BastaMasta/LumioV2/Hardware/LumioV2.pdf

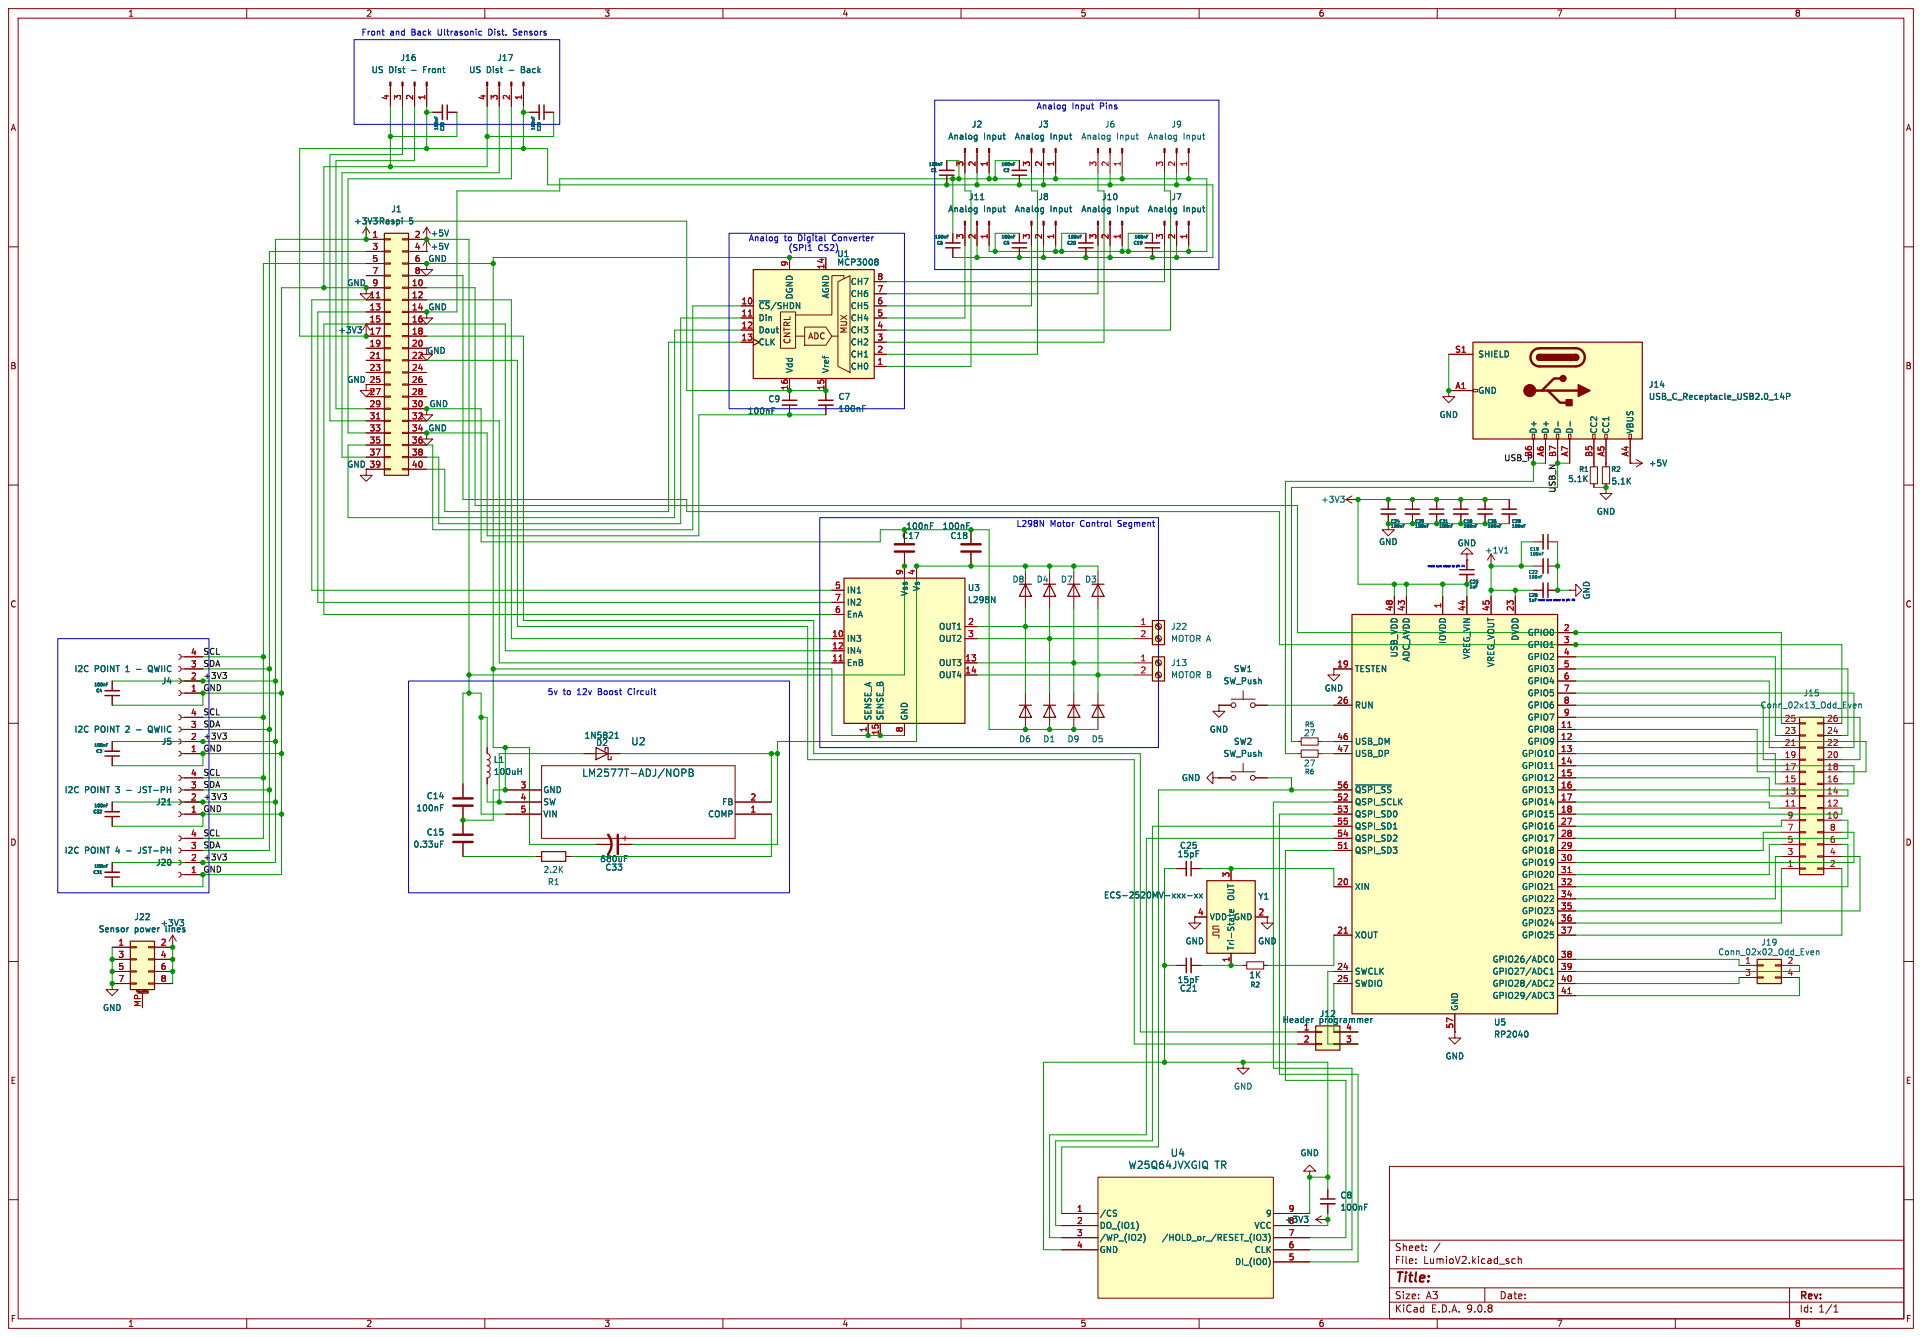
[picture p1: page 1]

1 GND 57 VREG_VIN 44 VREG_VOUT 45 DVDD 23 GPIO0 2 GPIO1 3 GPIO2 4 GPIO3 5 GPIO4 6 GPIO5 7 GPIO6 8 GPIO7 9 GPIO8 11 GPIO9 12 GPIO10 13 GPIO11 14 GPIO12 15 GPIO13 16 GPIO14 17 GPIO15 18 GPIO16 27 GPIO17 28 GPIO18 29 GPIO19 30 GPIO20 31 GPIO21 32 GPIO22 34 GPIO23 35 GPIO24 36 GPIO25 37 GPIO26/ADC0 38 GPIO27/ADC1 39 GPIO28/ADC2 40 GPIO29/ADC3 41 U5 RP2040 GND Tri-State
J12 Header programmer R6 27

3 ECS-2520MV-xxx-xx Y1 GND
