BastaMasta/LumioV2/(list of files, drawings)

Other design files:
Hardware/freerouting.dsn
Hardware/temp-freerouting.dsn
