BastaMasta/LumioV2/Hardware/LumioV2.kicad_pcb

## KiCad design Hardware/LumioV2.kicad_pcb (2026-04-07)

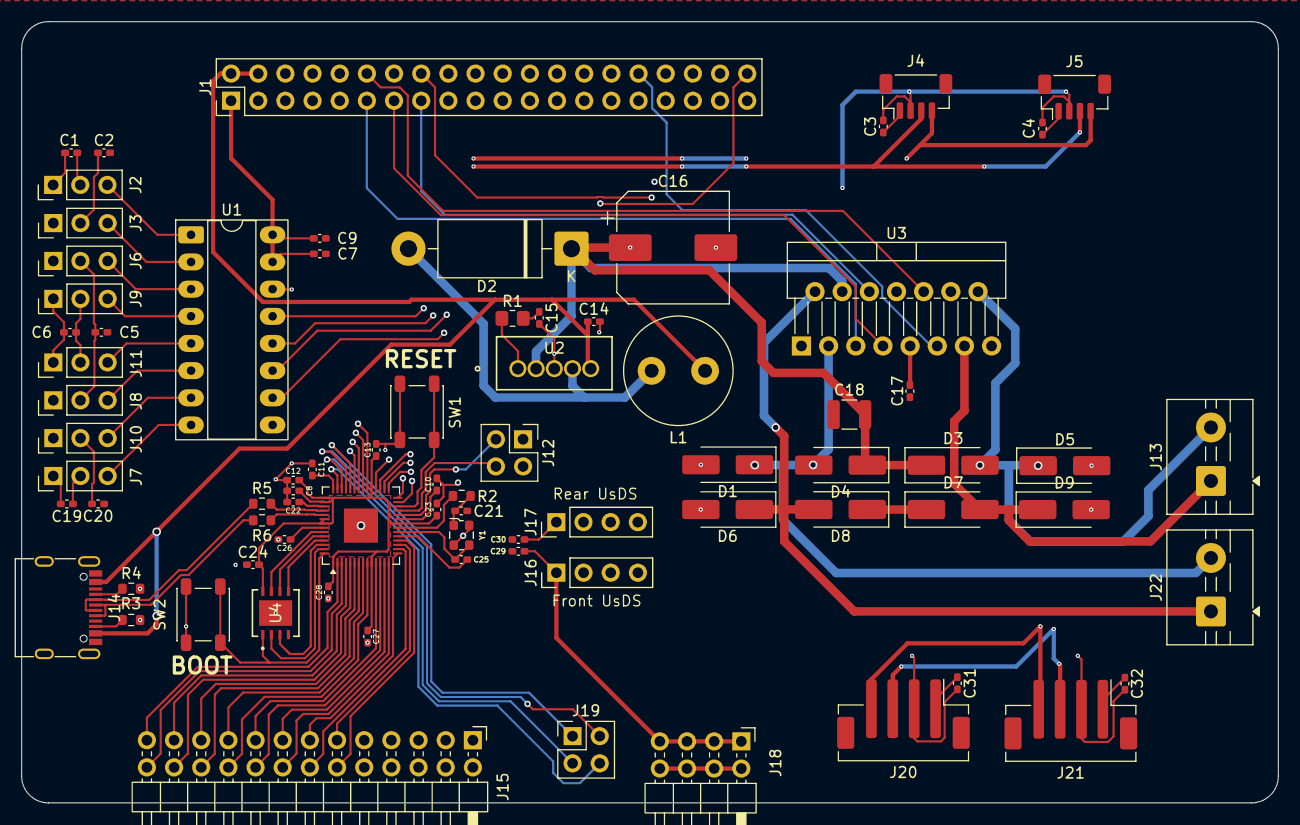
[picture p2: board LumioV2.kicad_pcb from above]

Board: 4 copper layers, 117.5 x 73.0 mm, 79 parts (1 on the bottom side), 86 nets.

Parts:
C1, C2, C3, C4, C5, C6, C7, C8, C9, C11, C12, C14, C17, C19, C20, C24, C28, C29, C30, C31, C32: 100nF; C_0402_1005Metric_Pad0.74x0.62mm_HandSolder
C10, C13, C22, C23, C26, C27: 1uF; C_0402_1005Metric_Pad0.74x0.62mm_HandSolder
C15: 0.33uF; C_0402_1005Metric_Pad0.74x0.62mm_HandSolder
C16, C33: 680uF; CP_Elec_10x10
C18: 100nF; C_1210_3225Metric
C21, C25: 15pF; C_0402_1005Metric_Pad0.74x0.62mm_HandSolder
D1, D3, D4, D5, D6, D7, D8, D9: SS34B; D_SMA_Handsoldering
D2: 1N5821; D_DO-201AD_P15.24mm_Horizontal
J1: Raspi 5; PinHeader_2x20_P2.54mm_Vertical
J2, J3, J6, J7, J8, J9, J10, J11: Analog Input; PinHeader_1x03_P2.54mm_Vertical
J4: I2C POINT 1 - QWIIC; JST_SH_BM04B-SRSS-TB_1x04-1MP_P1.00mm_Vertical
J5: I2C POINT 2 - QWIIC; JST_SH_BM04B-SRSS-TB_1x04-1MP_P1.00mm_Vertical
J12: Header programmer; PinHeader_2x02_P2.54mm_Vertical
J13: MOTOR B; TerminalBlock_MaiXu_MX126-5.0-02P_1x02_P5.00mm
J14: USB_C_Receptacle_USB2.0_14P; USB_C_Receptacle_G-Switch_GT-USB-7010ASV
J15: Conn_02x13_Odd_Even; PinHeader_2x13_P2.54mm_Horizontal
J16: US Dist - Front; PinHeader_1x04_P2.54mm_Vertical
J17: US Dist - Back; PinHeader_1x04_P2.54mm_Vertical
J18: Sensor power lines; PinHeader_2x04_P2.54mm_Horizontal
J19: Conn_02x02_Odd_Even; PinHeader_2x02_P2.54mm_Vertical
J20: I2C POINT 4 - JST-PH; JST_PH_B4B-PH-SM4-TB_1x04-1MP_P2.00mm_Vertical
J21: I2C POINT 3 - JST-PH; JST_PH_B4B-PH-SM4-TB_1x04-1MP_P2.00mm_Vertical
J22: MOTOR A; TerminalBlock_MaiXu_MX126-5.0-02P_1x02_P5.00mm
L1: 100uH; L_Radial_D10.0mm_P5.00mm_Fastron_07M
R1: 2.2K; R_0805_2012Metric_Pad1.20x1.40mm_HandSolder
R2: 1K; R_0603_1608Metric
R3, R4: 5.1K; R_0603_1608Metric
R5, R6: 27; R_0603_1608Metric
SW1, SW2: SW_Push; SW_SPST_PTS647_Sx50
U1: MCP3008; DIP-16_W7.62mm_Socket_LongPads
U2: LM2577T-ADJ/NOPB; T05A_TEX
U3: L298N; TO-220-15_P2.54x5.08mm_StaggerOdd_Lead4.58mm_Vertical
U4: DFN_XGIQ_TR_WIN; DFN_XGIQ TR_WIN-M
U5: RP2040; QFN-56-1EP_7x7mm_P0.4mm_EP3.2x3.2mm
Y1: ECS-2520MV-xxx-xx; Oscillator_SMD_ECS_2520MV-xxx-xx-4Pin_2.5x2.0mm

Connections:
+1V1: C10.2, C22.2, C26.2, U5.23 (DVDD), U5.45 (VREG_VOUT), U5.50 (DVDD)
+3V3: C1.1, C2.1, C3.2, C4.2, C5.1, C6.1, C7.1, C8.2, C9.1, C11.2, C12.2, C13.2, C19.1, C20.1, C23.2, C24.2, C27.2, C28.2, C29.2, C30.2, C31.2, C32.2, J1.1, J1.17 (3V3), J2.2, J3.2, J4.2, J5.2, J6.2, J7.2, J8.2, J9.2, J10.2, J11.2, J16.1, J17.1, J18.1, J18.3, J18.5, J18.7, J20.2, J21.2, U1.15 (Vref), U1.16 (Vdd), U4.8, U5.1 (IOVDD), U5.10 (IOVDD), U5.22 (IOVDD), U5.33 (IOVDD), U5.42 (IOVDD), U5.43 (ADC_AVDD), U5.44 (VREG_VIN), U5.48 (USB_VDD), U5.49 (IOVDD)
+5V: C14.1, C17.2, J1.2 (5V), J1.4 (5V), J14.A4 (VBUS), J14.A9 (VBUS), J14.B4 (VBUS), J14.B9 (VBUS), L1.1, U2.5 (VIN), U3.9 (Vss)
/SCL: J1.5, J4.4, J5.4, J20.4, J21.4
/SDA: J1.3 (SDA1), J4.3, J5.3, J20.3, J21.3
/USB_N: J14.A7 (D-), J14.B7 (D-), R5.1
/USB_P: J14.A6 (D+), J14.B6 (D+), R6.2
GND: C1.2, C2.2, C3.1, C4.1, C5.2, C6.2, C7.2, C8.1, C9.2, C10.1, C11.1, C12.1, C13.1, C14.2, C15.1, C16.2, C17.1, C18.1, C19.2, C20.2, C21.1, C22.1, C23.1, C24.1, C25.2, C26.1, C27.1, C28.1, C29.1, C30.1, C31.1, C32.1, C33.2, D1.2 (A), D5.2 (A), D6.2 (A), D9.2 (A), J1.6 (GND), J1.9 (GND), J1.14 (GND), J1.20 (GND), J1.25 (GND), J1.30 (GND), J1.34 (GND), J1.39 (GND), J2.1, J3.1, J4.1, J5.1, J6.1, J7.1, J8.1, J9.1, J10.1, J11.1, J14.A1 (GND), J14.A12 (GND), J14.B1 (GND), J14.B12 (GND), J14.S1 (SHIELD), J16.4, J17.4, J18.2, J18.4, J18.6, J18.8, J20.1, J21.1, R3.1, R4.2, SW1.1, SW2.1, U1.9 (DGND), U1.14 (AGND), U2.3 (GND), U3.1 (SENSE_A), U3.8 (GND), U3.15 (SENSE_B), U4.4, U4.9, U5.19 (TESTEN), U5.57 (GND), Y1.2 (GND), Y1.4 (VDD)
unnamed: C15.2, R1.1
unnamed: D1.1 (K), D4.2 (A), J22.2, U3.3 (OUT2)
unnamed: D2.2 (A), L1.2, U2.4 (SW)
unnamed: C16.1, C18.2, C33.1, D2.1 (K), D3.1 (K), D4.1 (K), D7.1 (K), D8.1 (K), U2.2 (FB), U3.4 (Vs)
unnamed: D3.2 (A), D5.1 (K), J13.2, U3.14 (OUT4)
unnamed: D6.1 (K), D8.2 (A), J22.1, U3.2 (OUT1)
unnamed: D7.2 (A), D9.1 (K), J13.1, U3.13 (OUT3)
unnamed: J1.8, J15.26, U5.3 (GPIO1)
unnamed: J1.10, J15.25, U5.2 (GPIO0)
unnamed: J1.11, U3.5 (IN1)
unnamed: J1.12, U3.10 (IN3)
unnamed: J1.13, U3.7 (IN2)
unnamed: J1.15, U3.6 (EnA)
unnamed: J1.16, U3.12 (IN4)
unnamed: J1.18, J12.1
unnamed: J1.22, J12.2
unnamed: J1.29, J16.2
unnamed: J1.31, J16.3
unnamed: J1.32, U3.11 (EnB)
unnamed: J1.33, J17.2
unnamed: J1.35, U1.12 (Dout)
unnamed: J1.36, U1.10 (~CS/SHDN)
unnamed: J1.37, J17.3
unnamed: J1.38, U1.11 (Din)
unnamed: J1.40, U1.13 (CLK)
unnamed: J14.A5 (CC1), R4.1
unnamed: J14.B5 (CC2), R3.2
unnamed: J15.1, U5.36 (GPIO24)
unnamed: J15.2, U5.37 (GPIO25)
unnamed: J15.3, U5.34 (GPIO22)
unnamed: J15.4, U5.35 (GPIO23)
unnamed: J15.5, U5.31 (GPIO20)
unnamed: J15.6, U5.32 (GPIO21)
unnamed: J15.7, U5.29 (GPIO18)
unnamed: J15.8, U5.30 (GPIO19)
unnamed: J15.9, U5.27 (GPIO16)
unnamed: J15.10, U5.28 (GPIO17)
unnamed: J15.11, U5.17 (GPIO14)
unnamed: J15.12, U5.18 (GPIO15)
unnamed: J15.13, U5.15 (GPIO12)
unnamed: J15.14, U5.16 (GPIO13)
unnamed: J15.15, U5.13 (GPIO10)
unnamed: J15.16, U5.14 (GPIO11)
unnamed: J15.17, U5.11 (GPIO8)
unnamed: J15.18, U5.12 (GPIO9)
unnamed: J15.19, U5.8 (GPIO6)
unnamed: J15.20, U5.9 (GPIO7)
unnamed: J15.21, U5.6 (GPIO4)
unnamed: J15.22, U5.7 (GPIO5)
unnamed: J15.23, U5.4 (GPIO2)
unnamed: J15.24, U5.5 (GPIO3)
unnamed: J2.3, U1.1 (CH0)
unnamed: J11.3, U1.5 (CH4)
unnamed: J3.3, U1.2 (CH1)
unnamed: J9.3, U1.4 (CH3)
unnamed: J10.3, U1.7 (CH6)
unnamed: J8.3, U1.6 (CH5)
unnamed: J6.3, U1.3 (CH2)
unnamed: J7.3, U1.8 (CH7)
unnamed: J12.3, U5.24 (SWCLK)
unnamed: J12.4, U5.25 (SWDIO)
unnamed: J19.1, U5.38 (GPIO26/ADC0)
unnamed: J19.2, U5.39 (GPIO27/ADC1)
unnamed: J19.3, U5.40 (GPIO28/ADC2)
unnamed: J19.4, U5.41 (GPIO29/ADC3)
unnamed: R1.2, U2.1 (COMP)
unnamed: U4.6, U5.52 (QSPI_SCLK)
unnamed: U4.5, U5.53 (QSPI_SD0)
unnamed: U4.2, U5.55 (QSPI_SD1)
unnamed: SW2.2, U4.1, U5.56 (~QSPI_SS)
unnamed: U4.7, U5.51 (QSPI_SD3)
unnamed: U4.3, U5.54 (QSPI_SD2)
unnamed: SW1.2, U5.26 (RUN)
unnamed: R5.2, U5.46 (USB_DM)
unnamed: R6.1, U5.47 (USB_DP)
unnamed: C25.1, U5.20 (XIN), Y1.3 (OUT)
unnamed: R2.1, U5.21 (XOUT)
unnamed: C21.2, R2.2, Y1.1 (Tri-State)
