BastaMasta/LumioV2/(commit log)

2026-03-28 init commit
    [LumioV2.kicad_pcb, LumioV2.kicad_sch]
2026-03-28 Added safety and pull circuit to the L298N block outputs
    [LumioV2.kicad_sch]
2026-03-30 correcrted pin orde rin schematics and added most footprints
    [LumioV2.kicad_sch]
2026-04-05 re-started routing, for clearer routes. also moved to dsi conenctor for display
    [LumioV2.kicad_pcb, LumioV2.kicad_sch]
2026-04-06 finished routing, added 3d files for most parts
    [LumioV2.kicad_pcb, LumioV2.kicad_sch]
2026-04-07 relocated files
    [LumioV2.kicad_pcb, LumioV2.kicad_sch, freerouting.dsn, temp-freerouting.dsn]
2026-04-09 added bom link
